ibanezgomez/FISBlocks/media/fis.gif

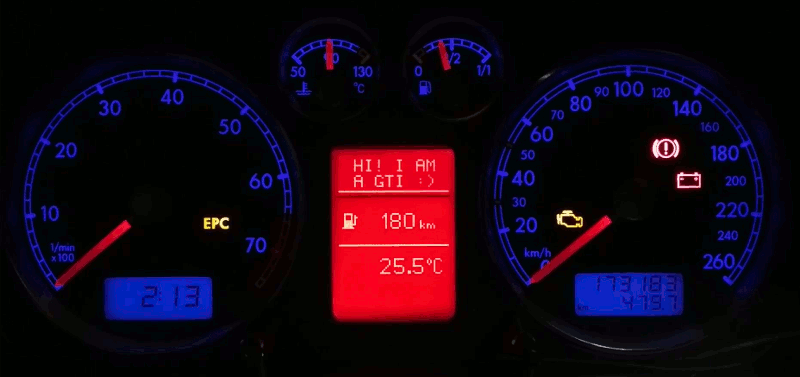
media/fis.gif
