ibanezgomez/FISBlocks/media/main.png

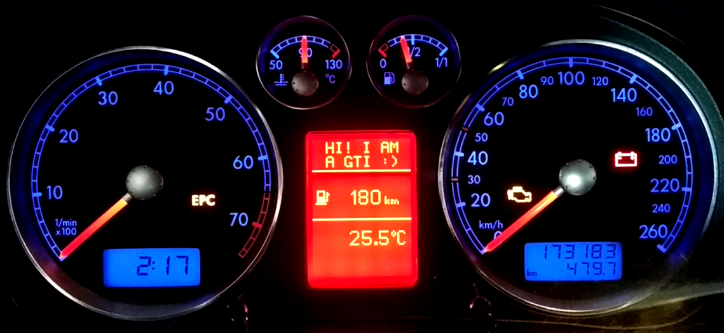
media/main.png
